jbebel/blubaru/blubaru.png

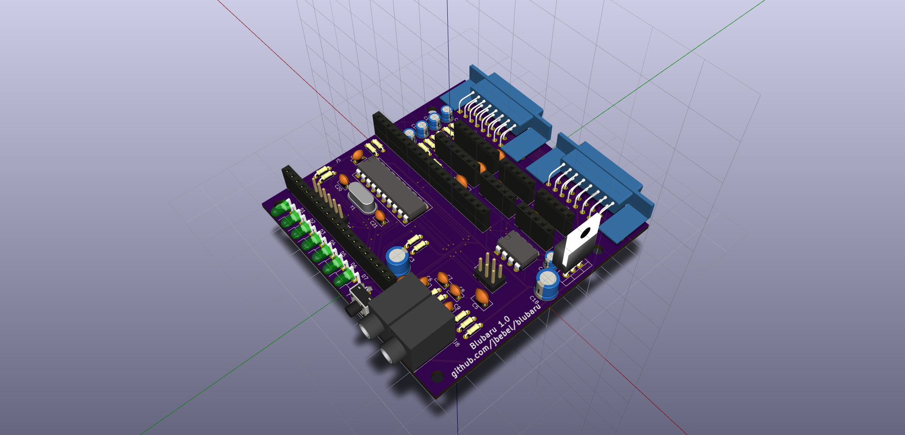
blubaru.png
