jbebel/blubaru/README.md

# blubaru
Bluetooth interface for my 2000 Subaru Legacy
