jbebel/blubaru/blubaru.kicad_pcb

## KiCad design blubaru.kicad_pcb (2018-05-31)

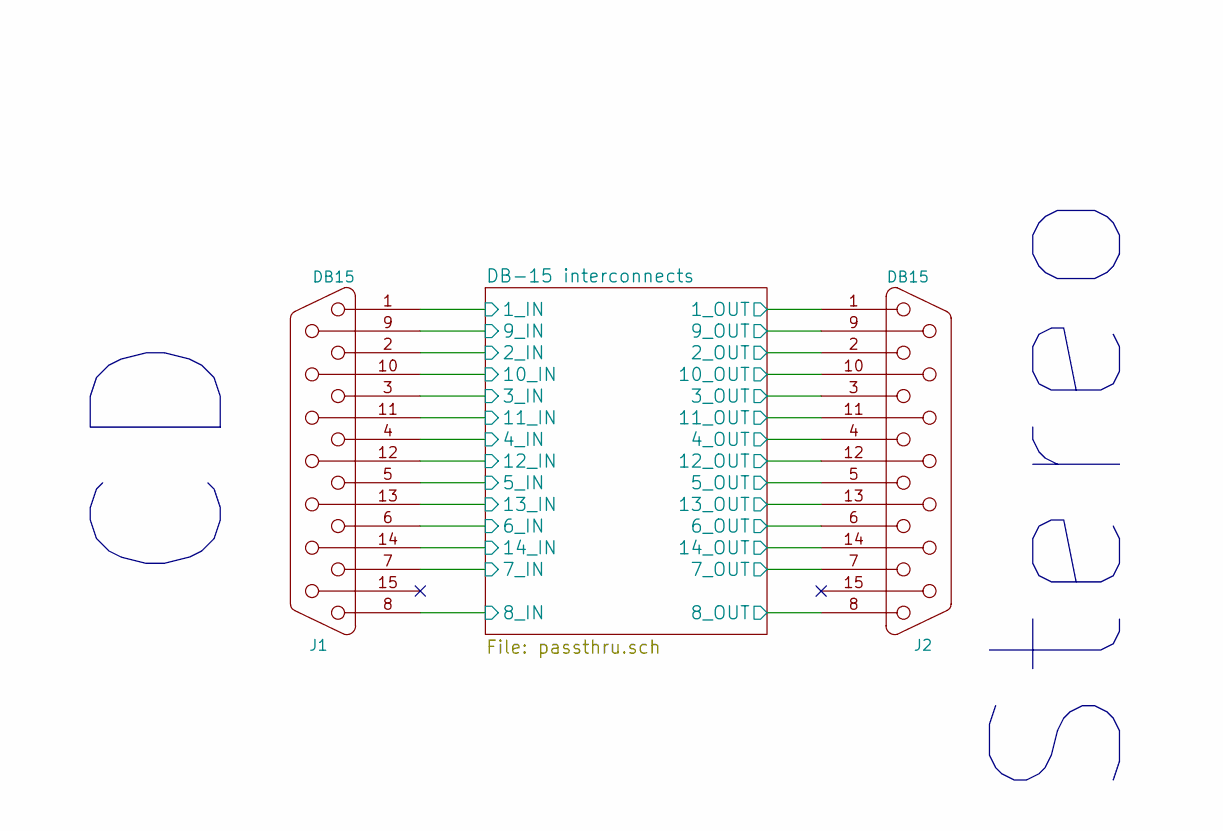
[picture p18: schematic blubaru.sch]

Parts:
J1: DB15; DB15FC
J2: DB15; DB15MC

Connections:
+BATT: J1.9, J2.9; also elsewhere on the board
/DB-15 interconnects/1_IN: J1.1, J2.1
/DB-15 interconnects/2_IN: J1.2; also elsewhere on the board
/DB-15 interconnects/2_OUT: J2.2; also elsewhere on the board
/DB-15 interconnects/3_IN: J1.3, J2.3
/DB-15 interconnects/4_IN: J1.4; also elsewhere on the board
/DB-15 interconnects/4_OUT: J2.4; also elsewhere on the board
/DB-15 interconnects/6_IN: J1.6; also elsewhere on the board
/DB-15 interconnects/6_OUT: J2.6; also elsewhere on the board
/DB-15 interconnects/7_IN: J1.7, J2.7
/DB-15 interconnects/8_IN: J1.8, J2.8
/DB-15 interconnects/10_IN: J1.10, J2.10
/DB-15 interconnects/11_IN: J1.11 (P111), J2.11 (P111)
/DB-15 interconnects/12_IN: J1.12, J2.12
/DB-15 interconnects/13_IN: J1.13, J2.13
GND: J1.14, J2.14; also elsewhere on the board
GNDA: J1.5, J2.5; also elsewhere on the board

Notes on the sheet:
Stereo

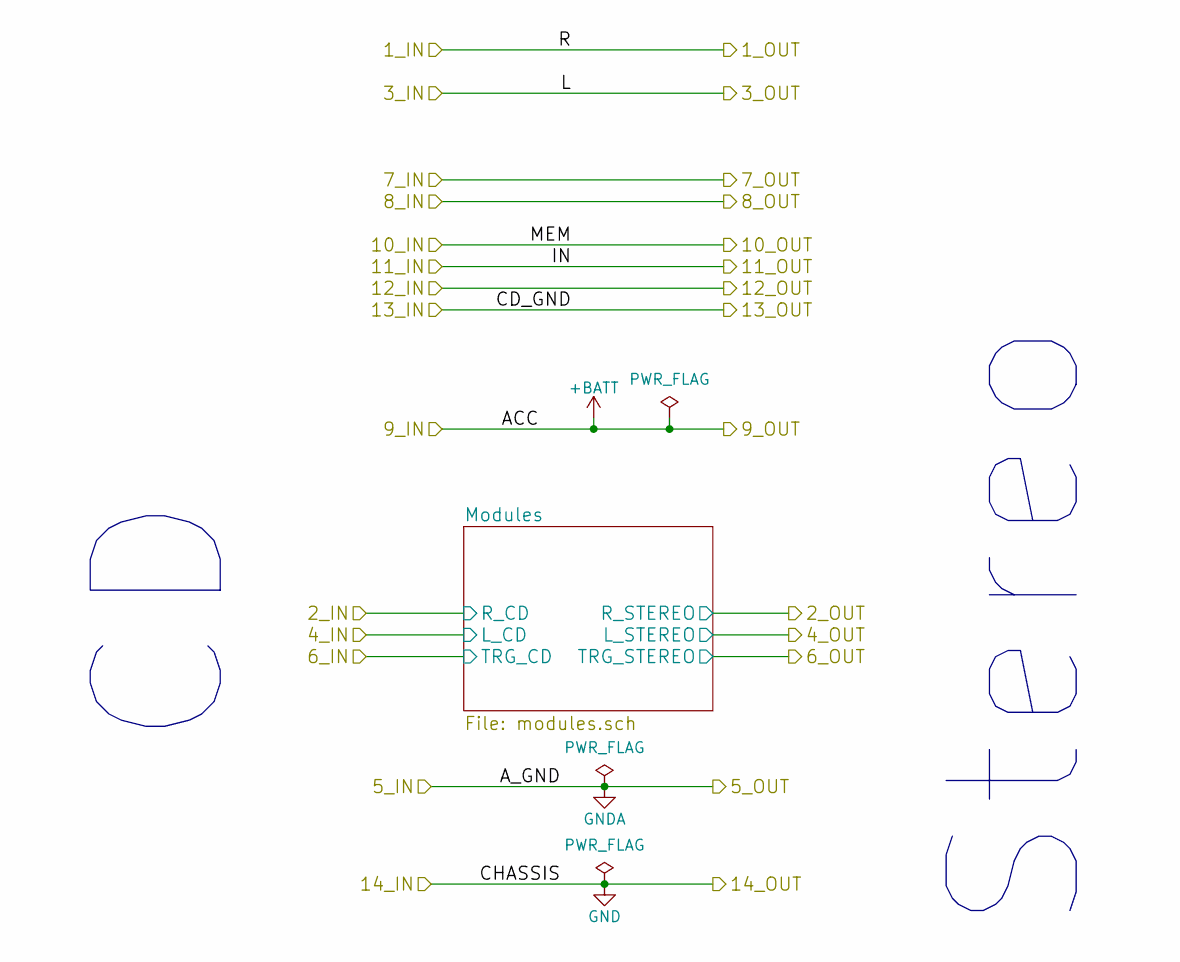
[picture p19: schematic passthru.sch, Blubaru]

Notes on the sheet:
Stereo

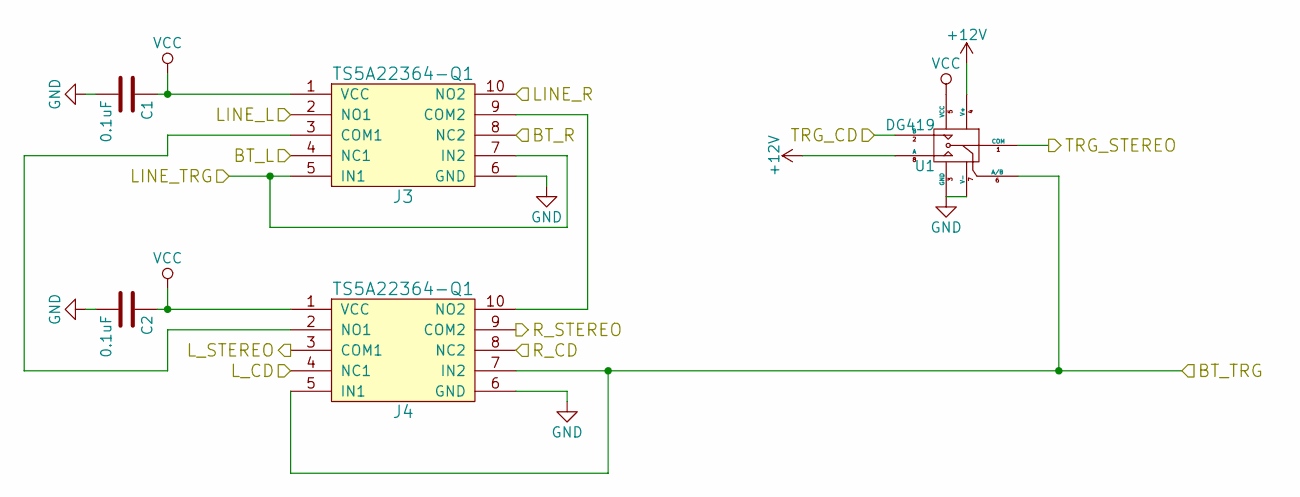
[picture p20: schematic switch.sch, Blubaru]

Parts:
C1, C2: 0.1uF; C_Disc_D4.0mm_W2.6mm_P2.50mm
J3, J4: TS5A22364-Q1
U1: DG419; DIP-8_W7.62mm

Connections:
+12V: U1.4 (V+), U1.8 (A); also elsewhere on the board
/DB-15 interconnects/2_IN: J4.8 (NC2); also elsewhere on the board
/DB-15 interconnects/2_OUT: J4.9 (COM2); also elsewhere on the board
/DB-15 interconnects/4_IN: J4.4 (NC1); also elsewhere on the board
/DB-15 interconnects/4_OUT: J4.3 (COM1); also elsewhere on the board
/DB-15 interconnects/6_IN: U1.2 (B); also elsewhere on the board
/DB-15 interconnects/6_OUT: U1.1 (COM); also elsewhere on the board
/DB-15 interconnects/Modules/Audio switch/BT_L: J3.4 (NC1); also elsewhere on the board
/DB-15 interconnects/Modules/Audio switch/BT_R: J3.8 (NC2); also elsewhere on the board
/DB-15 interconnects/Modules/Audio switch/BT_TRG: J4.5 (IN1), J4.7 (IN2), U1.6 (A/B); also elsewhere on the board
/DB-15 interconnects/Modules/Audio switch/LINE_L: J3.2 (NO1); also elsewhere on the board
/DB-15 interconnects/Modules/Audio switch/LINE_R: J3.10 (NO2); also elsewhere on the board
/DB-15 interconnects/Modules/Audio switch/LINE_TRG: J3.5 (IN1), J3.7 (IN2); also elsewhere on the board
GND: C1.2, C2.2, J3.6 (GND), J4.6 (GND), U1.3 (GND), U1.7 (V-); also elsewhere on the board
unnamed: J3.3 (COM1), J4.2 (NO1)
unnamed: J3.9 (COM2), J4.10 (NO2)
VCC: C1.1, C2.1, J3.1 (VCC), J4.1 (VCC), U1.5 (VCC); also elsewhere on the board

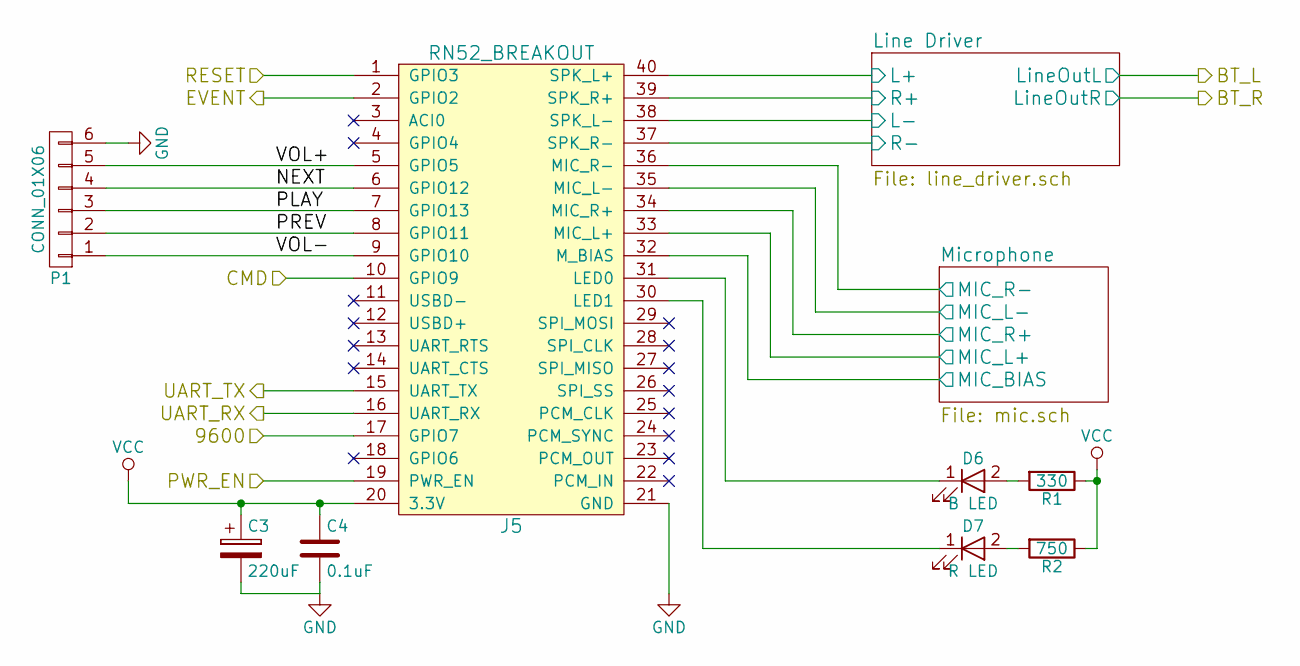
[picture p21: schematic bt.sch, Blubaru]

Parts:
C3: 220uF; CP_Radial_D6.3mm_P2.50mm
C4: 0.1uF; C_Disc_D4.0mm_W2.6mm_P2.50mm
D6: B LED; LED_D3.0mm_Horizontal_O1.27mm_Z6.0mm
D7: R LED; LED_D3.0mm_Horizontal_O1.27mm_Z6.0mm
J5: RN52_BREAKOUT; RN52_Breakout
P1: CONN_01X06; Pin_Header_Straight_1x06_Pitch2.54mm
R1: 330; R_Axial_DIN0204_L3.6mm_D1.6mm_P5.08mm_Horizontal
R2: 750; R_Axial_DIN0204_L3.6mm_D1.6mm_P5.08mm_Horizontal

Connections:
/DB-15 interconnects/Modules/Bluetooth Module/9600: J5.17 (GPIO7); also elsewhere on the board
/DB-15 interconnects/Modules/Bluetooth Module/CMD: J5.10 (GPIO9); also elsewhere on the board
/DB-15 interconnects/Modules/Bluetooth Module/EVENT: J5.2 (GPIO2); also elsewhere on the board
/DB-15 interconnects/Modules/Bluetooth Module/Line Driver/L+: J5.40 (SPK_L+); also elsewhere on the board
/DB-15 interconnects/Modules/Bluetooth Module/Line Driver/L-: J5.38 (SPK_L-); also elsewhere on the board
/DB-15 interconnects/Modules/Bluetooth Module/Line Driver/R+: J5.39 (SPK_R+); also elsewhere on the board
/DB-15 interconnects/Modules/Bluetooth Module/Line Driver/R-: J5.37 (SPK_R-); also elsewhere on the board
/DB-15 interconnects/Modules/Bluetooth Module/Microphone/MIC_BIAS: J5.32 (M_BIAS); also elsewhere on the board
/DB-15 interconnects/Modules/Bluetooth Module/Microphone/MIC_L+: J5.33 (MIC_L+); also elsewhere on the board
/DB-15 interconnects/Modules/Bluetooth Module/Microphone/MIC_L-: J5.35 (MIC_L-); also elsewhere on the board
/DB-15 interconnects/Modules/Bluetooth Module/Microphone/MIC_R+: J5.34 (MIC_R+); also elsewhere on the board
/DB-15 interconnects/Modules/Bluetooth Module/Microphone/MIC_R-: J5.36 (MIC_R-); also elsewhere on the board
/DB-15 interconnects/Modules/Bluetooth Module/NEXT: J5.6 (GPIO12), P1.4
/DB-15 interconnects/Modules/Bluetooth Module/PLAY: J5.7 (GPIO13), P1.3
/DB-15 interconnects/Modules/Bluetooth Module/PREV: J5.8 (GPIO11), P1.2
/DB-15 interconnects/Modules/Bluetooth Module/PWR_EN: J5.19 (PWR_EN); also elsewhere on the board
/DB-15 interconnects/Modules/Bluetooth Module/UART_RX: J5.16 (UART_RX); also elsewhere on the board
/DB-15 interconnects/Modules/Bluetooth Module/UART_TX: J5.15 (UART_TX); also elsewhere on the board
/DB-15 interconnects/Modules/Bluetooth Module/VOL+: J5.5 (GPIO5), P1.5
/DB-15 interconnects/Modules/Bluetooth Module/VOL-: J5.9 (GPIO10), P1.1
/DB-15 interconnects/Modules/Microcontroller/BT_RESET: J5.1 (GPIO3); also elsewhere on the board
GND: C3.2, C4.2, J5.21 (GND), P1.6; also elsewhere on the board
unnamed: D6.1 (K), J5.31 (LED0)
unnamed: D6.2 (A), R1.2
unnamed: D7.1 (K), J5.30 (LED1)
unnamed: D7.2 (A), R2.2
VCC: C3.1, C4.1, J5.20 (3.3V), R1.1, R2.1; also elsewhere on the board

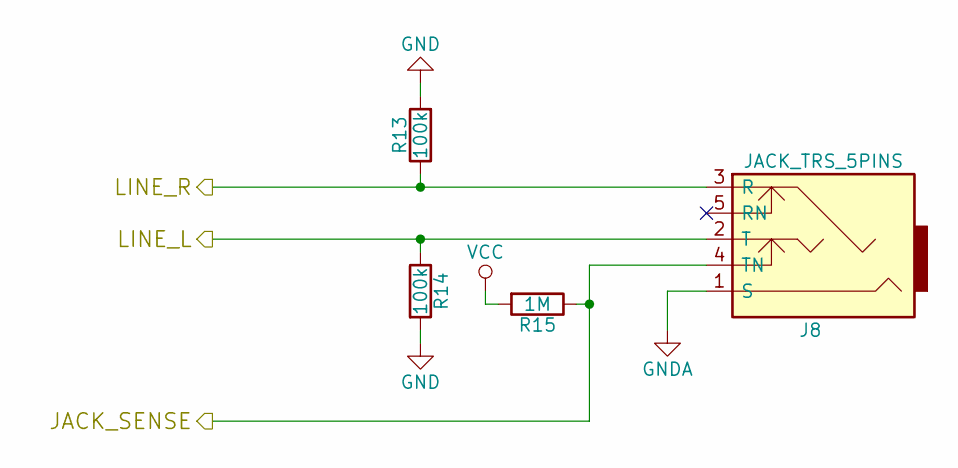
[picture p22: schematic line_in.sch]

Parts:
J8: JACK_TRS_5PINS; sj1-353xng
R13, R14: 100k; R_Axial_DIN0204_L3.6mm_D1.6mm_P5.08mm_Horizontal
R15: 1M; R_Axial_DIN0204_L3.6mm_D1.6mm_P5.08mm_Horizontal

Connections:
/DB-15 interconnects/Modules/Audio switch/LINE_L: J8.2 (T), R14.1; also elsewhere on the board
/DB-15 interconnects/Modules/Audio switch/LINE_R: J8.3 (R), R13.1; also elsewhere on the board
/DB-15 interconnects/Modules/Line In/JACK_SENSE: J8.4 (TN), R15.1; also elsewhere on the board
GND: R13.2, R14.2; also elsewhere on the board
GNDA: J8.1 (S); also elsewhere on the board
VCC: R15.2; also elsewhere on the board

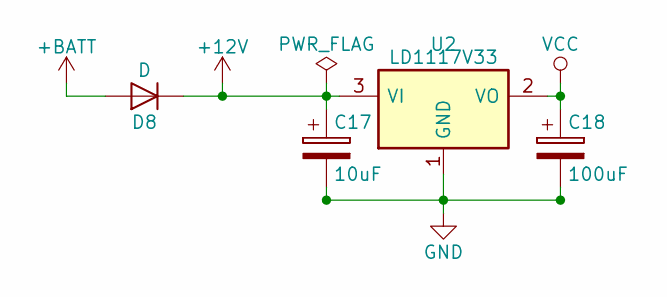
[picture p23: schematic regulator.sch, Blubaru]

Parts:
C17: 10uF; CP_Radial_D4.0mm_P1.50mm
C18: 100uF; CP_Radial_D6.3mm_P2.50mm
D8: D; D_DO-41_SOD81_P7.62mm_Horizontal
U2: LD1117V33; TO-220_Vertical

Connections:
+12V: C17.1, D8.1 (K), U2.3 (VI); also elsewhere on the board
+BATT: D8.2 (A); also elsewhere on the board
GND: C17.2, C18.2, U2.1 (GND); also elsewhere on the board
VCC: C18.1, U2.2 (VO); also elsewhere on the board

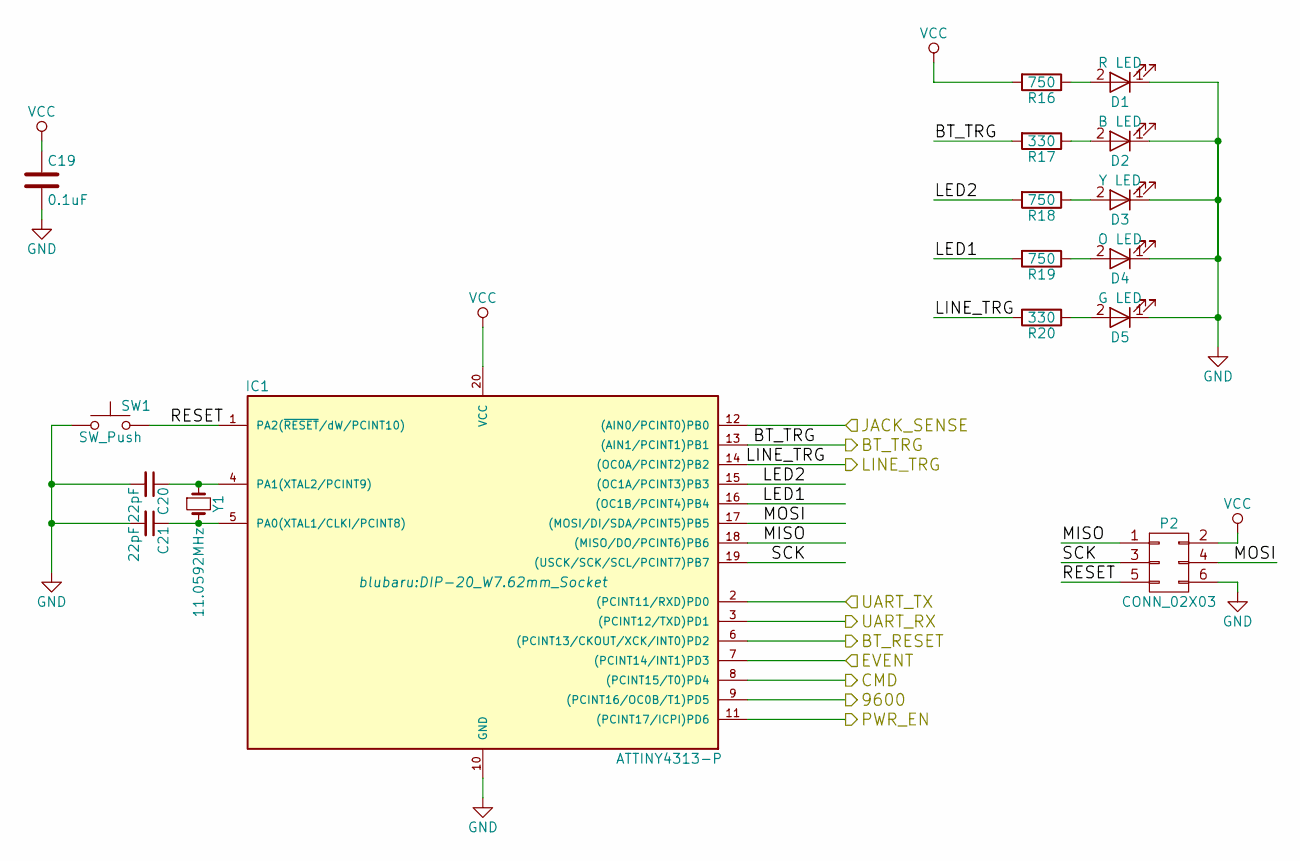
[picture p24: schematic control.sch, Blubaru]

Parts:
C19: 0.1uF; C_Disc_D4.0mm_W2.6mm_P2.50mm
C20, C21: 22pF; C_Disc_D4.0mm_W2.6mm_P2.50mm
D1: R LED; LED_D3.0mm_Horizontal_O1.27mm_Z6.0mm
D2: B LED; LED_D3.0mm_Horizontal_O1.27mm_Z6.0mm
D3: Y LED; LED_D3.0mm_Horizontal_O1.27mm_Z6.0mm
D4: O LED; LED_D3.0mm_Horizontal_O1.27mm_Z6.0mm
D5: G LED; LED_D3.0mm_Horizontal_O1.27mm_Z6.0mm
IC1: ATTINY4313-P; DIP-20_W7.62mm_Socket
P2: CONN_02X03; Pin_Header_Straight_2x03_Pitch2.54mm
R16, R18, R19: 750; R_Axial_DIN0204_L3.6mm_D1.6mm_P5.08mm_Horizontal
R17, R20: 330; R_Axial_DIN0204_L3.6mm_D1.6mm_P5.08mm_Horizontal
SW1: SW_Push; SW_Tactile_SPST_Angled_PTS645Vx58-2LFS
Y1: 11.0592MHz; Crystal_HC49-4H_Vertical

Connections:
/DB-15 interconnects/Modules/Audio switch/BT_TRG: IC1.13 ((AIN1/PCINT1)PB1), R17.2; also elsewhere on the board
/DB-15 interconnects/Modules/Audio switch/LINE_TRG: IC1.14 ((OC0A/PCINT2)PB2), R20.2; also elsewhere on the board
/DB-15 interconnects/Modules/Bluetooth Module/9600: IC1.9 ((PCINT16/OC0B/T1)PD5); also elsewhere on the board
/DB-15 interconnects/Modules/Bluetooth Module/CMD: IC1.8 ((PCINT15/T0)PD4); also elsewhere on the board
/DB-15 interconnects/Modules/Bluetooth Module/EVENT: IC1.7 ((PCINT14/INT1)PD3); also elsewhere on the board
/DB-15 interconnects/Modules/Bluetooth Module/PWR_EN: IC1.11 ((PCINT17/ICPI)PD6); also elsewhere on the board
/DB-15 interconnects/Modules/Bluetooth Module/UART_RX: IC1.3 ((PCINT12/TXD)PD1); also elsewhere on the board
/DB-15 interconnects/Modules/Bluetooth Module/UART_TX: IC1.2 ((PCINT11/RXD)PD0); also elsewhere on the board
/DB-15 interconnects/Modules/Line In/JACK_SENSE: IC1.12 ((AIN0/PCINT0)PB0); also elsewhere on the board
/DB-15 interconnects/Modules/Microcontroller/BT_RESET: IC1.6 ((PCINT13/CKOUT/XCK/INT0)PD2); also elsewhere on the board
/DB-15 interconnects/Modules/Microcontroller/LED1: IC1.16 ((OC1B/PCINT4)PB4), R19.2
/DB-15 interconnects/Modules/Microcontroller/LED2: IC1.15 ((OC1A/PCINT3)PB3), R18.2
/DB-15 interconnects/Modules/Microcontroller/MISO: IC1.18 ((MISO/DO/PCINT6)PB6), P2.1
/DB-15 interconnects/Modules/Microcontroller/MOSI: IC1.17 ((MOSI/DI/SDA/PCINT5)PB5), P2.4
/DB-15 interconnects/Modules/Microcontroller/RESET: IC1.1 (PA2(~RESET~/dW/PCINT10)), P2.5, SW1.2
/DB-15 interconnects/Modules/Microcontroller/SCK: IC1.19 ((USCK/SCK/SCL/PCINT7)PB7), P2.3
GND: C19.2, C20.2, C21.2, D1.1 (K), D2.1 (K), D3.1 (K), D4.1 (K), D5.1 (K), IC1.10 (GND), P2.6, SW1.1; also elsewhere on the board
unnamed: C20.1, IC1.4 (PA1(XTAL2/PCINT9)), Y1.1
unnamed: C21.1, IC1.5 (PA0(XTAL1/CLKI/PCINT8)), Y1.2
unnamed: D1.2 (A), R16.1
unnamed: D2.2 (A), R17.1
unnamed: D3.2 (A), R18.1
unnamed: D4.2 (A), R19.1
unnamed: D5.2 (A), R20.1
VCC: C19.1, IC1.20 (VCC), P2.2, R16.2; also elsewhere on the board

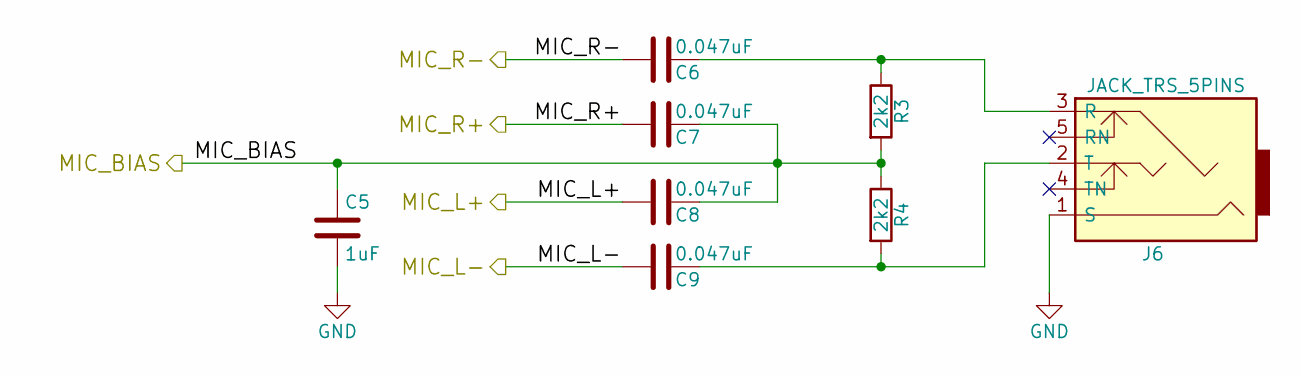
[picture p25: schematic mic.sch, Blubaru]

Parts:
C5: 1uF; C_Disc_D5.0mm_W3.2mm_P2.50mm
C6, C7, C8, C9: 0.047uF; C_Disc_D4.0mm_W2.6mm_P2.50mm
J6: JACK_TRS_5PINS; sj1-353xng
R3, R4: 2k2; R_Axial_DIN0204_L3.6mm_D1.6mm_P5.08mm_Horizontal

Connections:
/DB-15 interconnects/Modules/Bluetooth Module/Microphone/MIC_BIAS: C5.1, C7.1, C8.1, R3.2, R4.1; also elsewhere on the board
/DB-15 interconnects/Modules/Bluetooth Module/Microphone/MIC_L+: C8.2; also elsewhere on the board
/DB-15 interconnects/Modules/Bluetooth Module/Microphone/MIC_L-: C9.2; also elsewhere on the board
/DB-15 interconnects/Modules/Bluetooth Module/Microphone/MIC_R+: C7.2; also elsewhere on the board
/DB-15 interconnects/Modules/Bluetooth Module/Microphone/MIC_R-: C6.2; also elsewhere on the board
GND: C5.2, J6.1 (S); also elsewhere on the board
unnamed: C6.1, J6.3 (R), R3.1
unnamed: C9.1, J6.2 (T), R4.2

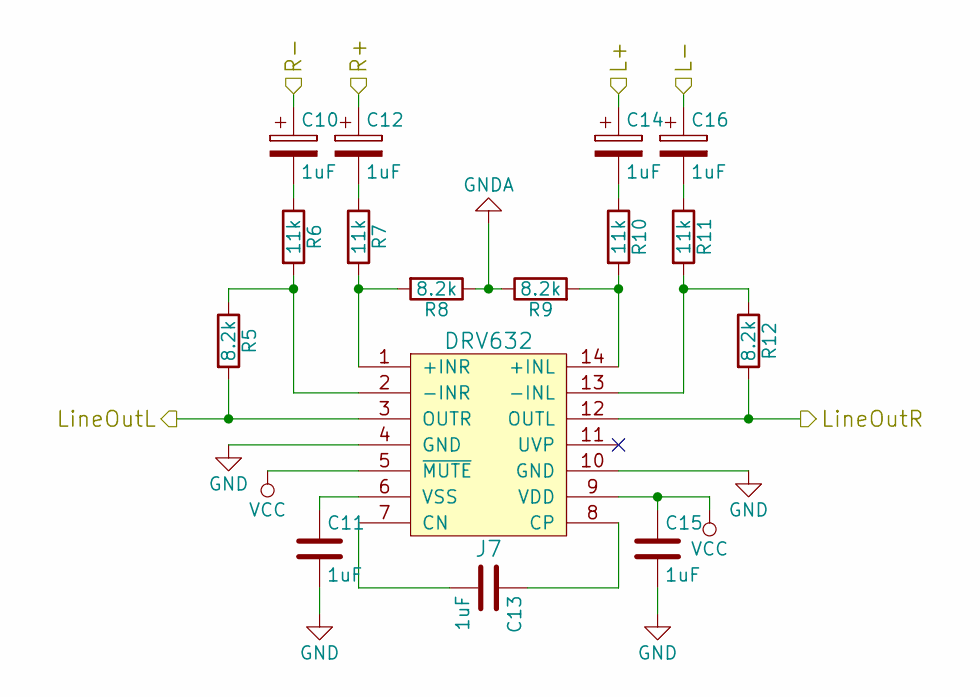
[picture p26: schematic line_driver.sch]

Parts:
C10, C12, C14, C16: 1uF; CP_Radial_D4.0mm_P1.50mm
C11, C13, C15: 1uF; C_Disc_D5.0mm_W3.2mm_P2.50mm
J7: DRV632
R5, R8, R9, R12: 8.2k; R_Axial_DIN0204_L3.6mm_D1.6mm_P5.08mm_Horizontal
R6, R7, R10, R11: 11k; R_Axial_DIN0204_L3.6mm_D1.6mm_P5.08mm_Horizontal

Connections:
/DB-15 interconnects/Modules/Audio switch/BT_L: J7.3 (OUTR), R5.2; also elsewhere on the board
/DB-15 interconnects/Modules/Audio switch/BT_R: J7.12 (OUTL), R12.2; also elsewhere on the board
/DB-15 interconnects/Modules/Bluetooth Module/Line Driver/L+: C14.1; also elsewhere on the board
/DB-15 interconnects/Modules/Bluetooth Module/Line Driver/L-: C16.1; also elsewhere on the board
/DB-15 interconnects/Modules/Bluetooth Module/Line Driver/R+: C12.1; also elsewhere on the board
/DB-15 interconnects/Modules/Bluetooth Module/Line Driver/R-: C10.1; also elsewhere on the board
GND: C11.2, C15.2, J7.4 (GND), J7.10 (GND); also elsewhere on the board
GNDA: R8.1, R9.1; also elsewhere on the board
unnamed: C10.2, R6.1
unnamed: C11.1, J7.6 (VSS)
unnamed: C12.2, R7.1
unnamed: C13.1, J7.8 (CP)
unnamed: C13.2, J7.7 (CN)
unnamed: C14.2, R10.1
unnamed: C16.2, R11.1
unnamed: J7.1 (+INR), R7.2, R8.2
unnamed: J7.2 (-INR), R5.1, R6.2
unnamed: J7.13 (-INL), R11.2, R12.1
unnamed: J7.14 (+INL), R9.2, R10.2
VCC: C15.1, J7.5 (~MUTE), J7.9 (VDD); also elsewhere on the board

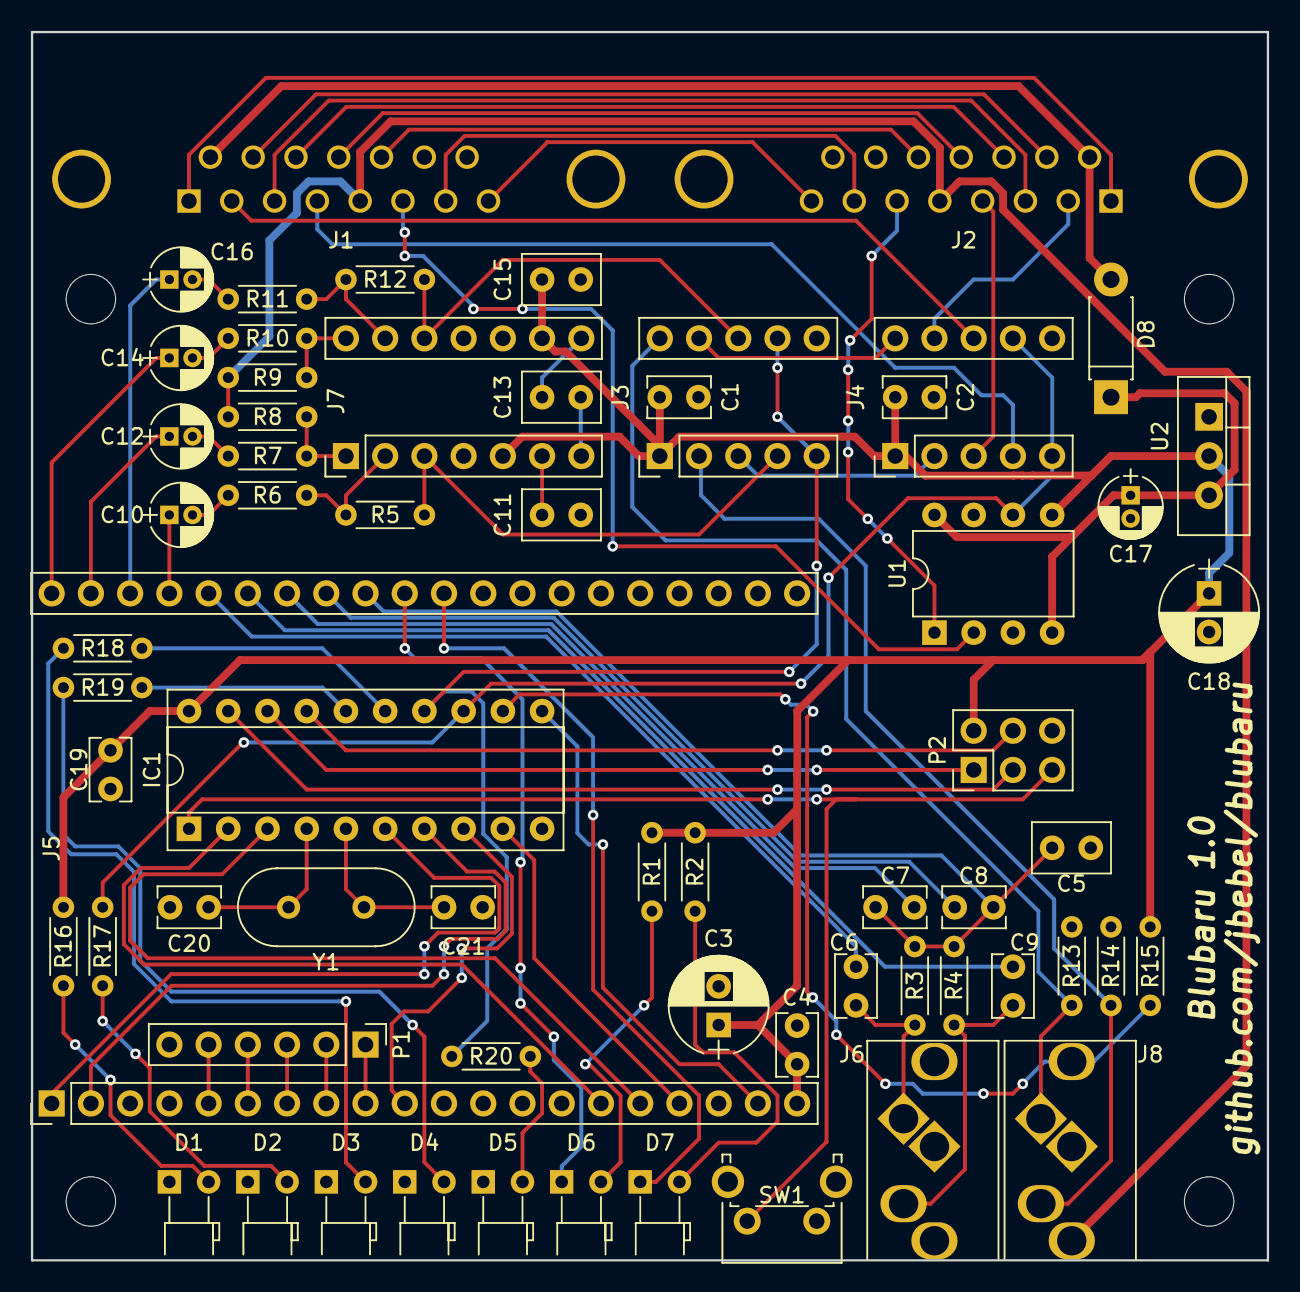
[picture p27: board blubaru.kicad_pcb from above]

Board: 2 copper layers, 80.0 x 79.5 mm, 64 parts (0 on the bottom side), 79 nets.
