jbebel/blubaru/(commit log)

2017-02-07 Initial commit with a few components.
    [blubaru.kicad_pcb, blubaru.sch]
2017-02-08 Make connections to components on amplifier.
    [blubaru.sch]
2017-02-08 Add the RN52 to my library and schematic
    [blubaru.sch]
2017-02-08 Add DB15s and a cap on the breakout.
    [blubaru.sch]
2017-02-09 Add ProMicro board and DB15 labels
    [blubaru.sch]
2017-02-10 Add a microphone jack
    [blubaru.sch]
2017-02-11 Add a mic jack and a header for buttons.
    [blubaru.sch]
2017-02-15 Make a virtual audio switch part.
    [blubaru.sch]
2017-02-25 Break up into hierarchical sheets.
    [amp.sch, blubaru.sch, bt.sch, control.sch, mic.sch, modules.sch, passthru.sch, switch.sch]
2017-02-28 Put parts in the audio switch page.
    [amp.sch, blubaru.sch, bt.sch, control.sch, mic.sch, switch.sch]
2017-03-03 Create footprints for breakout boards
    [_saved_amp.sch, _saved_control.sch, amp.sch, blubaru.sch, bt.sch, control.sch, mic.sch, modules.sch]
2017-03-03 Actually save the schematics that I had open.
    [amp.sch, bt.sch, control.sch, switch.sch]
2017-03-03 Create pcb file with design rules matching oshpark
    [blubaru.kicad_pcb]
2017-03-04 Update footprints for passives.
    [amp.sch, blubaru.dsn, blubaru_jbebel.kicad_pcb, blubaru_rpwoodbu.kicad_pcb, mic.sch]
2017-03-04 Added footprint for audio jack.
    [blubaru.kicad_pcb, mic.sch]
2017-03-07 Update footprints for breakouts and jack
2017-03-08 Add a new 5-pin jack to schematic library and use it.
    [mic.sch]
2017-03-08 re-pair new 5-pin jack with footprint
    [mic.sch]
2017-03-08 Update netlist to use 5-pin jack
2017-03-09 Move everything up a directory
    [amp.sch, blubaru.kicad_pcb, blubaru.sch, blubaru_jbebel.kicad_pcb, blubaru_rpwoodbu.kicad_pcb, bt.sch, control.sch, mic.sch]
2017-03-10 Add datasheet links
    [amp.sch, bt.sch, control.sch, mic.sch, switch.sch]
2017-03-10 Switch pin headers to socket strips
2017-03-19 Correct footprints for caps and DB15s
    [amp.sch, blubaru.sch, bt.sch, mic.sch]
2017-05-02 FIx labels
    Swapped incorrect L+ and L- labels
    [amp.sch]
2017-05-05 Add an LED indicator to the trigger
    [modules.sch]
2017-05-14 Add a line_driver schematic
    This branch contains the full line driver with 2nd order filter, which
    provides a low-pass filter on the input.
    [amp.sch, bt.sch, control.sch, line_driver.sch, mic.sch, modules.sch, switch.sch]
2017-06-01 Fix the schematic to use the new DRV632 component.
    [line_driver.sch]
2017-06-02 Add keywords to part and datasheet to schematic for DRV632
    [line_driver.sch]
2017-06-02 add component values and footprints.
    [line_driver.sch, modules.sch]
2017-06-03 Add part for TS5A22364-Q1 and replace FSA2269 with it.
    [switch.sch]
2017-06-03 Add a ProMini part, and genericize wiring to work with either.
    [control.sch]
2017-06-04 Add footprints for audio switch and amp.
    [line_driver.sch, switch.sch]
2017-06-04 Add RC filter on line-outs, matching the EVM.
    [line_driver.sch]
2017-06-05 Adjust some cap prefixes and add large CD/Stereo labels to top level pages.
    [blubaru.sch, line_driver.sch, mic.sch, passthru.sch]
2017-06-19 Add LEDs to MCU and polarized caps on line driver.
    [bt.sch, control.sch, line_driver.sch, mic.sch, modules.sch, passthru.sch, switch.sch]
2017-06-19 Add resistor values to LEDs and a voltage regulator. Has power pin errors still.
    [bt.sch, control.sch, line_driver.sch, mic.sch, modules.sch, passthru.sch, switch.sch]
2017-06-25 Voltage regulator adjustments and tidying
    Switch to LD1117 component and add decoupling caps.
    Add a decoupling cap to the audio switch
    Shift some status LEDs to modules layer
    Use ProMini instead of ProMicro
    Update BOM
    Update netlist
    [bt.sch, control.sch, line_driver.sch, mic.sch, modules.sch, passthru.sch, switch.sch]
2017-06-28 Add new capacitor footprints and associate them.
    [bt.sch, line_driver.sch, mic.sch, switch.sch]
2017-06-28 Apply new footprints to net file and BOM.
2017-06-28 Add some datasheets to footprints
2017-06-28 Add some datasheets to schematics.
    [bt.sch, control.sch, line_driver.sch, mic.sch, modules.sch, switch.sch]
2017-06-28 Regenerate BOM and net with new datasheets.
2017-06-28 Fix 3D model scale for some caps.
    [line_driver.sch, modules.sch]
2017-07-06 Fix labels and lay resistors flat.
    Left inputs to the line driver were backwards, because the datasheet had
    an error. I think I "fixed"it before to match the datasheet.
    I also decided to lay the resistors flat. They don't take up that much
    room flat, and they will be easier to make pretty on the board, and more
    stable with all the vibration.
    Also updated the BOM and netlist.
    [control.sch, line_driver.sch, mic.sch, modules.sch]
2017-07-28 Add a line in module and use a smaller jack.
    Lots of changes:
    Added a line in. This requires another audio switch, so that's added to
    the audio switch module.
    Also, since I'm using two jacks, I chose a smaller jack module. This
    needed a new footprint, and a new 3d model. The footprint is trickier,
    since it really needed slots, which OSH won't guarantee. I've given it a
    unique footprint to try to optimize the pad size around the edges of the
    pins.
    [blubaru.sch, bt.sch, control.sch, line_driver.sch, line_in.sch, mic.sch, modules.sch, passthru.sch]
2017-09-13 Reduce the line driver back to simple
    After determining the gain needed to be 0.735 (which is out of spec for
    the amp), I was unsure what to do with the 2nd order filter on the amp.
    It wasn't even present on the headphone amp from before, and I suspect
    the head unit in the car does some filtering of its own. To simplify
    things, I removed the second order filter and went back to a simple line
    driver. I also set the values of the gain setting resistors to 8.2 and
    11, which gets as close as I can to 0.735 gain using single E24
    resistors.
    [line_driver.sch, line_in.sch, regulator.sch]
2017-09-19 Separate audio ground from power ground
    The connection between the CD player and stereo has a separate line for
    audio ground and the chassis ground. I didn't previously understand why
    this was necessary, so I tied them together. They were tied together in
    the stereo anyway. The reason is that when using power, there must be
    current returning on the ground line, and since that ground line is not
    free of resistance, that causes a slight voltage change. That voltage
    difference causes a disagreement in what ground is, and at audio levels,
    that makes a significant difference. By isolating the audio ground to a
    separate wire that doesn't carry current, we keep the ground potential
    the same between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
    [line_driver.sch, line_in.sch, passthru.sch]
2017-09-26 Adjust some positioning for better readability
    [mic.sch, regulator.sch]
2017-09-26 Fix page layout for two that were still on A4.
    [line_driver.sch, line_in.sch]
2017-11-03 Major update to use Atmel ATTINY4313
    Replace Pro Micro as microcontroller. Mostly contianed within the
    control sheet.
    Moved LEDs all onto control sheet.
    Updated a few capacitors.
    Added a reset switch. Still need to decide part.
    Updated a few capacitor models for 4.0.7
    [bt.sch, control.sch, control_promicro.sch, line_driver.sch, line_in.sch, mic.sch, modules.sch, passthru.sch]
2017-11-23 Add LEDs to BT module
    These already exist on the breakout board, but they will be more visible
    if I add resistors to the front panel. They can be removed if space is
    limited and the case is translucent, but add them for now. In V2, there
    won't be a breakout board, so adding them now makes the V1 to V2 fewer
    changes.
    [bt.sch, control.sch, line_driver.sch, line_in.sch, mic.sch, regulator.sch]
2017-12-17 Add footprints for LEDs and tactile switches
    Also create an initial layout for fun.
    [blubaru.kicad_pcb, bt.sch, control.sch]
2017-12-17 Add a better footprint for the regulator
    [blubaru.kicad_pcb, regulator.sch]
2017-12-18 Clean up some schematics for readability.
    Run 12V from after power protection diode.
    [bt.sch, mic.sch, passthru.sch, regulator.sch]
2017-12-18 Rough layout with short audio path.
    [blubaru.kicad_pcb]
2017-12-18 Re-add MCU footprint and use vertical regul.
    [control.sch, regulator.sch]
2017-12-18 Update layout with new netlist
    [blubaru.kicad_pcb]
2017-12-18 Remove extraneous center line from LEDs
2017-12-18 Add an outline for the BT antenna.
2017-12-18 First feasible layout.
    [blubaru.kicad_pcb]
2017-12-18 Power and audio paths connected.
    [blubaru.kicad_pcb]
2017-12-18 Fixup mic jack parts after schematic change (rebase).
    Some parts got flipped in 04f718b, onto which subsequent comments got rebased
    later.
    [blubaru.kicad_pcb]
2018-01-11 Rename the bluetooth reset line
    This is needed so it doesn't conflict with the MCU reset line of the
    same name. Apparently that puts them on the same net.
    Also, reorder the LEDs so they have nicer numbers on the board.
    [bt.sch, control.sch, mic.sch, modules.sch, passthru.sch, regulator.sch]
2018-01-11 Update net names, re-arrange LEDs
    Separated the RESET and BT_RESET nets. They collided previously.
    Renamed components after a few things shifted around.
    Moved LEDs around so they are in order.
    [blubaru.kicad_pcb]
2018-02-08 jbebels attempt at routing
    All power and audio is routed, as is the crystal and UART lines. Other
    digital lines remain, and the resistors for the LEDs are moved off-board
    until I figure out the best place for them.
    This also required a small fix to the schematic. A junction was missing,
    causing the audio grounds to not be connected to the cd/stereo audio
    ground.
    [blubaru.kicad_pcb, blubaru_jbebel.kicad_pcb, blubaru_rpwoodbu.kicad_pcb, control.sch, line_driver.sch, passthru.sch]
2018-02-22 First full layout
    I renumbered pins on the MCU so that the layout was cleaner, hence the
    regenerated net file.
    This passes all the design rules and nothing is unconnected. I managed
    to get the ground pour connected without having to pour between pins,
    but it seems even better connected if I do, and it is within the design
    rules, so it seems safe.
    [blubaru.kicad_pcb, control.sch]
2018-03-15 Adjust some tolerances around traces and vias.
    [blubaru.kicad_pcb]
2018-03-16 More layout tweaks for tolerances and appearance.
    [blubaru.kicad_pcb]
2018-03-16 Add some logos to the back.
    [blubaru.kicad_pcb]
2018-03-16 Remove obsolete _rpwoodbu layout.
    [blubaru_rpwoodbu.kicad_pcb]
2018-05-31 Include more layers in layout view
    Also include PDF of schematic and layout, as well as a png of the 3D
    view.
    [blubaru.kicad_pcb]
